Peter-Schenkels/MRB-Ballancer/(commit log)

2022-06-08 add PID
2022-06-09 update to PID and rtos
